DianaMircea/Signal-Generator-OrCAD/(list of files, drawings)

Other design files:
SIGNAL_GENERATOR.DSN
Signal_Generator.opj
